kgl2001/BeebSCSIHostAdaptor/README.md

# BeebSCSIHostAdaptor
SCSI Host Adaptor that allows BBC &amp; Master Computers to interface with various SCSI Hard Disk Drives.

Please refer to the following discussion on Stardot for further details: https://stardot.org.uk/forums/viewtopic.php?f=3&t=18815

## Author

BeebSCSIHostAdaptor is developed and maintained by Ken Lowe.

The design is based on the BeebSCSI project by Simon Inns: https://github.com/simoninns/BeebSCSI

## Software License (GPLv3)

    BeebSCSI is free software: you can redistribute it and/or modify
    it under the terms of the GNU General Public License as published by
    the Free Software Foundation, either version 3 of the License, or
    (at your option) any later version.

    BeebSCSI is distributed in the hope that it will be useful,
    but WITHOUT ANY WARRANTY; without even the implied warranty of
    MERCHANTABILITY or FITNESS FOR A PARTICULAR PURPOSE.  See the
    GNU General Public License for more details.

    You should have received a copy of the GNU General Public License
    along with BeebSCSI.  If not, see <http://www.gnu.org/licenses/>.
    
## Hardware License (Creative Commons BY-SA 4.0)

Please see the following link for details: https://creativecommons.org/licenses/by-sa/4.0/

You are free to:

Share - copy and redistribute the material in any medium or format
Adapt - remix, transform, and build upon the material
for any purpose, even commercially.

This license is acceptable for Free Cultural Works.

The licensor cannot revoke these freedoms as long as you follow the license terms.

Under the following terms:

Attribution - You must give appropriate credit, provide a link to the license, and indicate if changes were made. You may do so in any reasonable manner, but not in any way that suggests the licensor endorses you or your use.

ShareAlike - If you remix, transform, or build upon the material, you must distribute your contributions under the same license as the original.

No additional restrictions - You may not apply legal terms or technological measures that legally restrict others from doing anything the license permits.
