kgl2001/BeebSCSIHostAdaptor/SCSIConnector - 80 pin/SCSIConnector.kicad_pcb

## KiCad design SCSIConnector - 80 pin/SCSIConnector.kicad_pcb (2021-02-13)

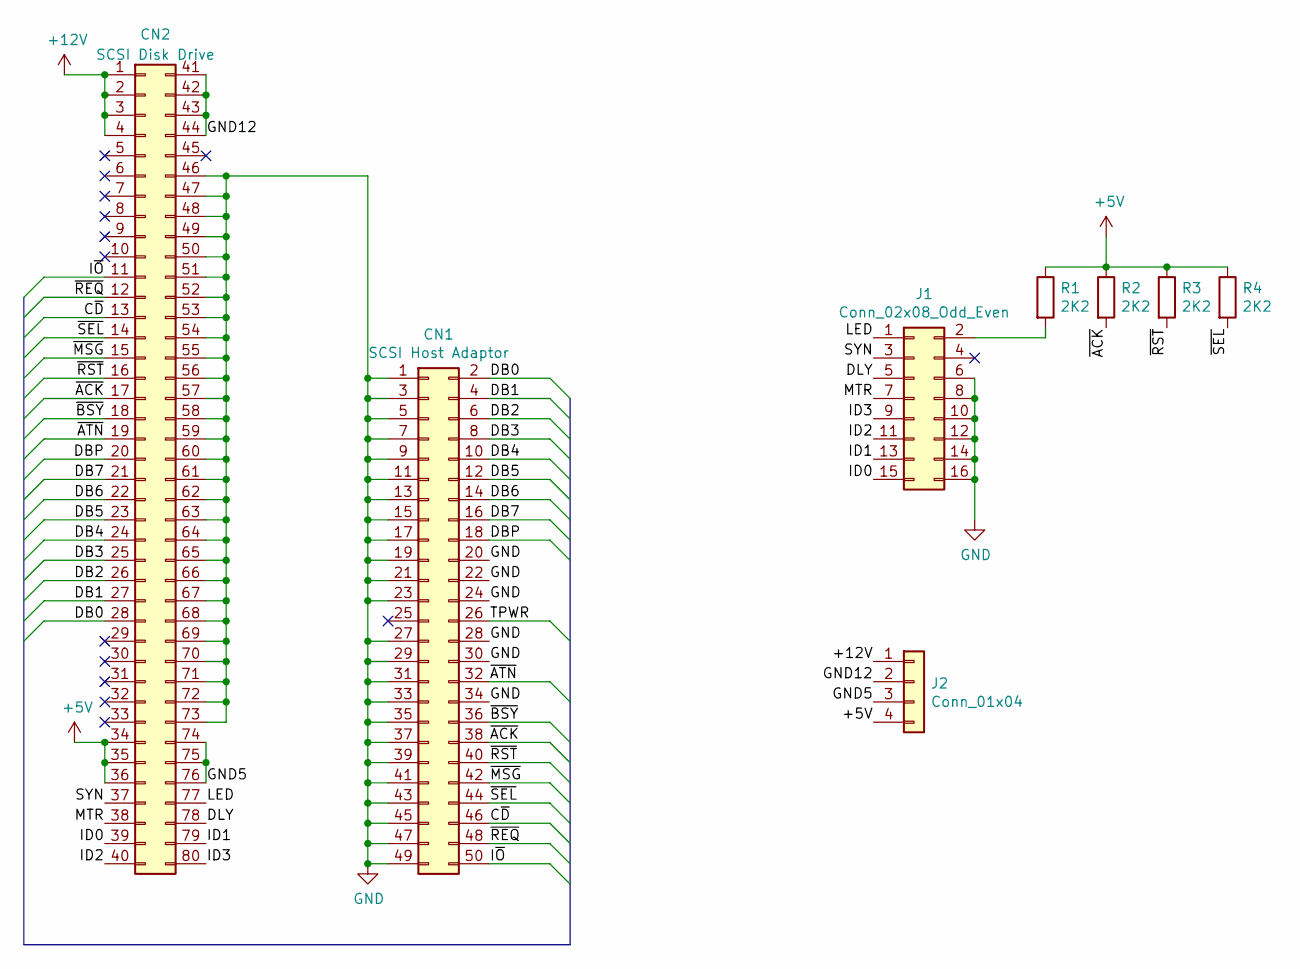
[picture p1: schematic SCSIConnector.sch]

Parts:
CN1: SCSI Host Adaptor; PinSocket_2x25_P2.54mm_Vertical
CN2: SCSI Disk Drive; TE_787311-4
J1: Conn_02x08_Odd_Even; PinHeader_2x08_P2.54mm_Vertical
J2: Conn_01x04; conn_hdd_15-24-4449
R1, R2, R3, R4: 2K2; R_Axial_DIN0204_L3.6mm_D1.6mm_P5.08mm_Horizontal

Connections:
+5V: CN2.34, CN2.35, CN2.36, J2.4, R1.1, R2.1, R3.1, R4.1
+12V: CN2.1, CN2.2, CN2.3, CN2.4, J2.1
/C~D: CN1.46, CN2.13
/DB0: CN1.2, CN2.28
/DB1: CN1.4, CN2.27
/DB2: CN1.6, CN2.26
/DB3: CN1.8, CN2.25
/DB4: CN1.10, CN2.24
/DB5: CN1.12, CN2.23
/DB6: CN1.14, CN2.22
/DB7: CN1.16, CN2.21
/DBP: CN1.18, CN2.20
/DLY: CN2.78, J1.5
/GND5: CN2.74, CN2.75, CN2.76, J2.3
/GND12: CN2.41, CN2.42, CN2.43, CN2.44, J2.2
/ID0: CN2.39, J1.15
/ID1: CN2.79, J1.13
/ID2: CN2.40, J1.11
/ID3: CN2.80, J1.9
/I~O: CN1.50, CN2.11
/LED: CN2.77, J1.1
/MTR: CN2.38, J1.7
/SYN: CN2.37, J1.3
/TPWR: CN1.26
/~ACK: CN1.38, CN2.17, R2.2
/~ATN: CN1.32, CN2.19
/~BSY: CN1.36, CN2.18
/~MSG: CN1.42, CN2.15
/~REQ: CN1.48, CN2.12
/~RST: CN1.40, CN2.16, R3.2
/~SEL: CN1.44, CN2.14, R4.2
GND: CN1.1, CN1.3, CN1.5, CN1.7, CN1.9, CN1.11, CN1.13, CN1.15, CN1.17, CN1.19, CN1.20, CN1.21, CN1.22, CN1.23, CN1.24, CN1.27, CN1.28, CN1.29, CN1.30, CN1.31, CN1.33, CN1.34, CN1.35, CN1.37, CN1.39, CN1.41, CN1.43, CN1.45, CN1.47, CN1.49, CN2.46, CN2.47, CN2.48, CN2.49, CN2.50, CN2.51, CN2.52, CN2.53, CN2.54, CN2.55, CN2.56, CN2.57, CN2.58, CN2.59, CN2.60, CN2.61, CN2.62, CN2.63, CN2.64, CN2.65, CN2.66, CN2.67, CN2.68, CN2.69, CN2.70, CN2.71, CN2.72, CN2.73, J1.6, J1.8, J1.10, J1.12, J1.14, J1.16
unnamed: J1.2, R1.2

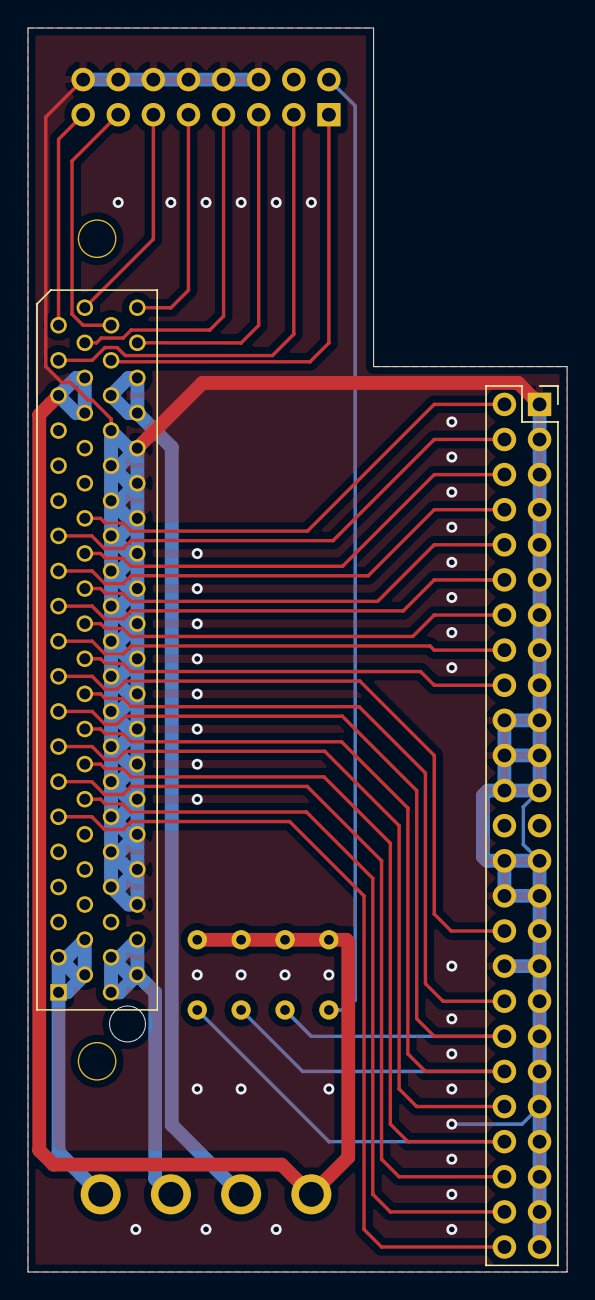
[picture p2: board SCSIConnector.kicad_pcb from above]

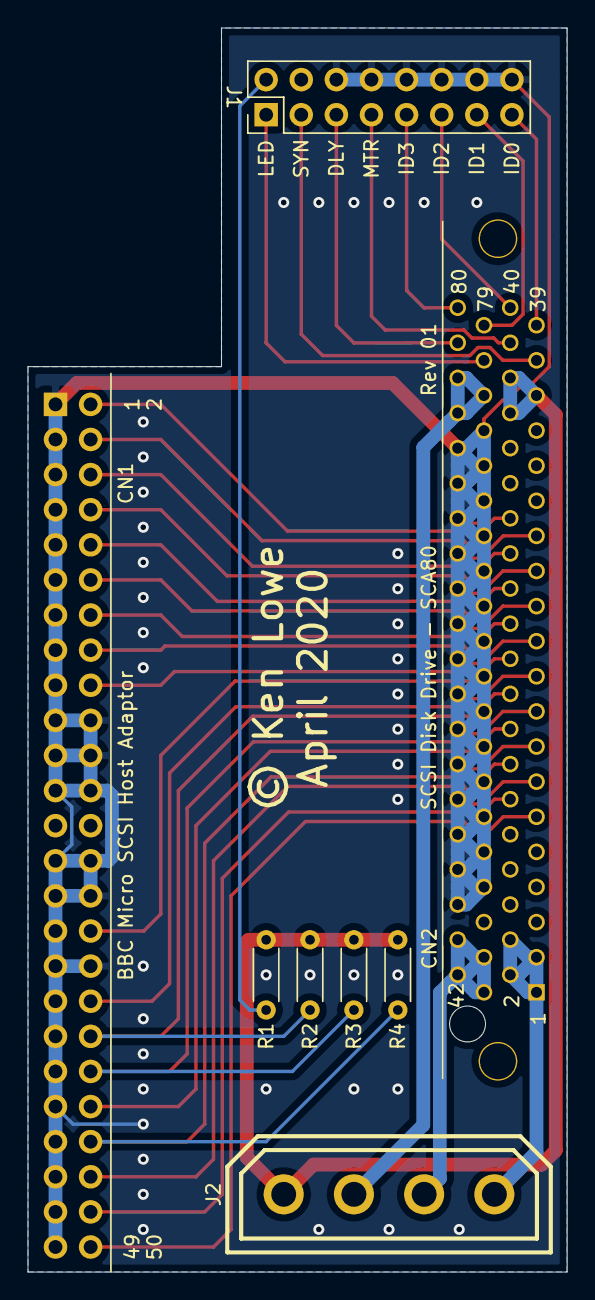
[picture p3: board SCSIConnector.kicad_pcb from below]

Board: 2 copper layers, 39.0 x 90.0 mm, 8 parts (6 on the bottom side), 32 nets.
