kgl2001/BeebSCSIHostAdaptor/SCSIConnector - 80 pin Buffered/SCSIConnectorA.kicad_pcb

## KiCad design SCSIConnector - 80 pin Buffered/SCSIConnectorA.kicad_pcb (2021-02-13)

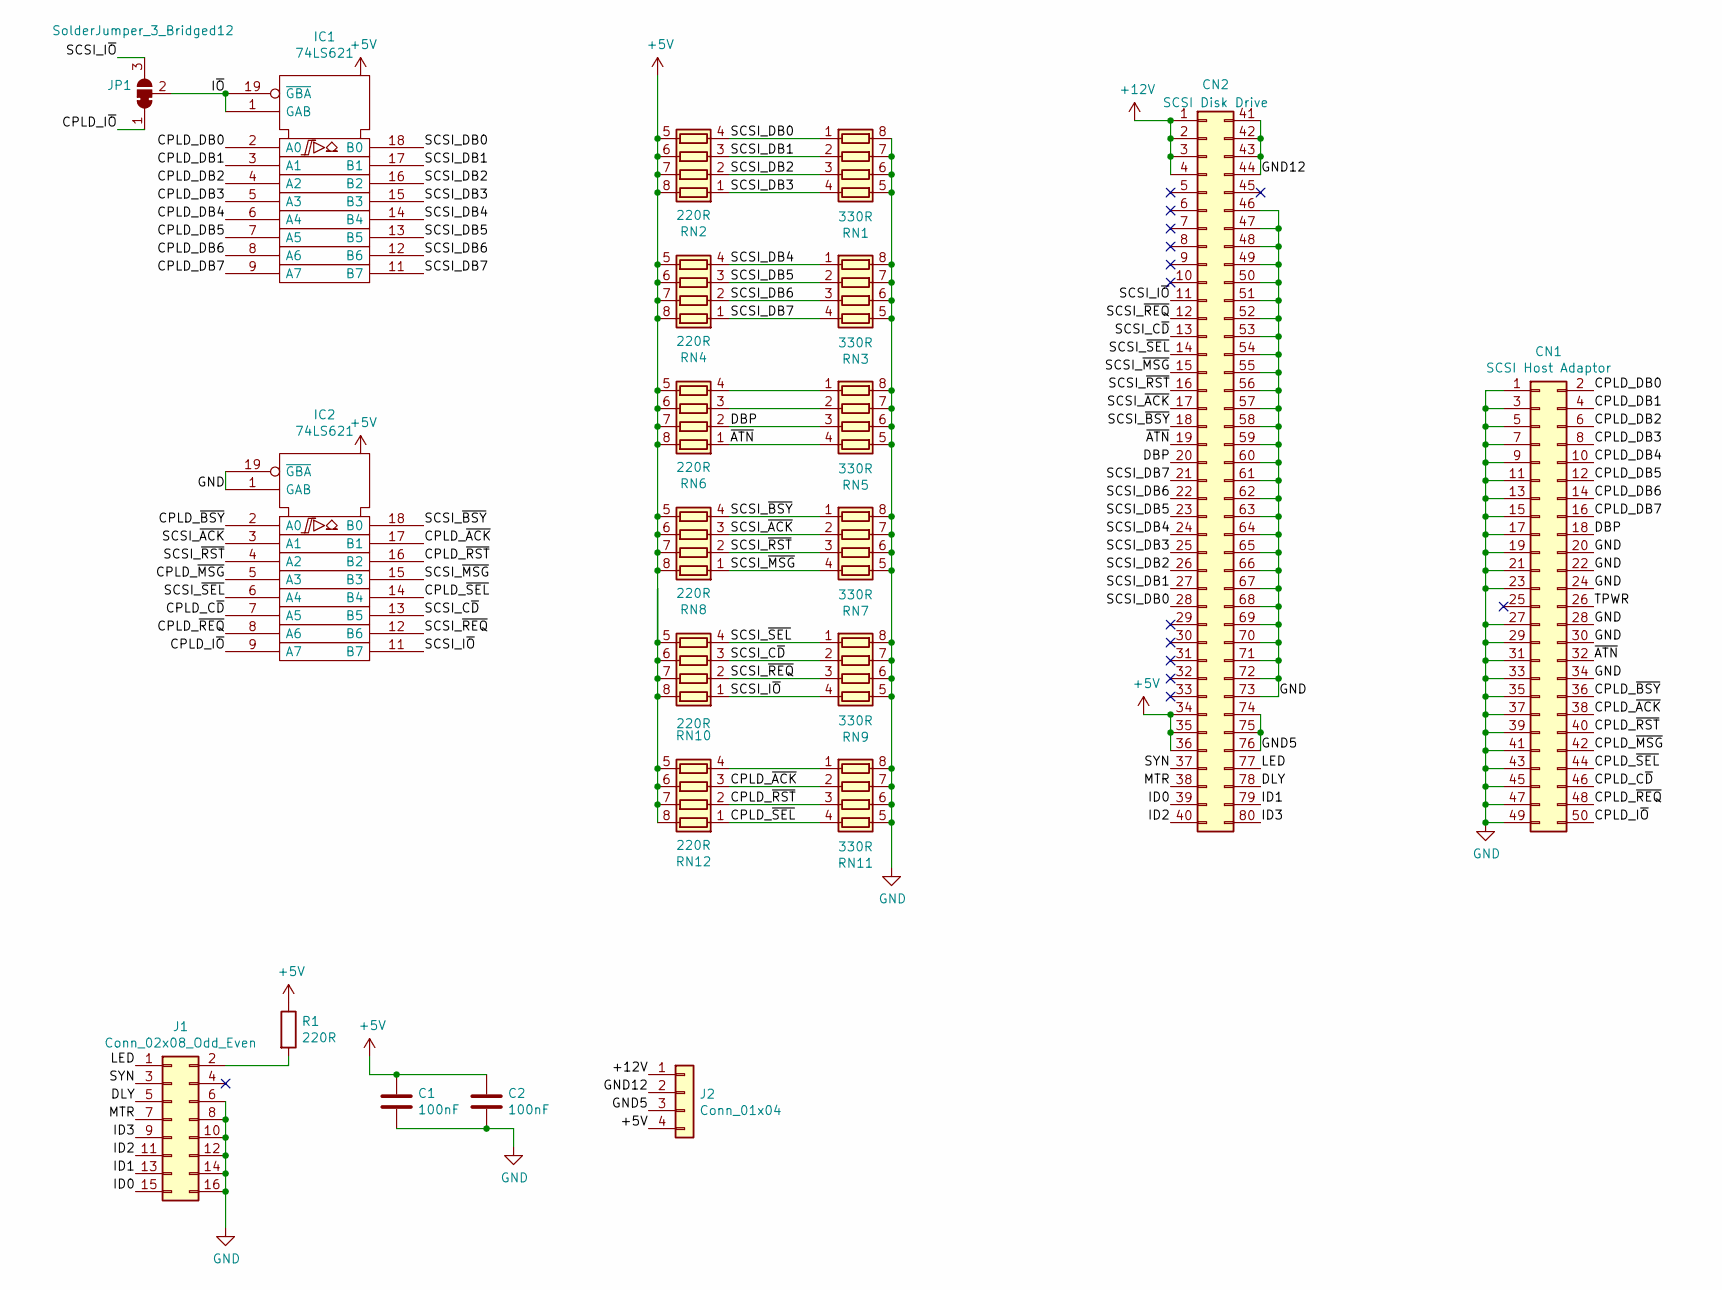
[picture p4: schematic SCSIConnectorA.sch]

Parts:
C1, C2: 100nF; C_0603_1608Metric
CN1: SCSI Host Adaptor; PinSocket_2x25_P2.54mm_Vertical
CN2: SCSI Disk Drive; TE_787311-4
IC1, IC2: 74LS621; SOIC-20W_7.5x12.8mm_P1.27mm
J1: Conn_02x08_Odd_Even; PinHeader_2x08_P2.54mm_Vertical
J2: Conn_01x04; conn_hdd_15-24-4449
JP1: SolderJumper_3_Bridged12; SolderJumper-3_P1.3mm_Bridged12_RoundedPad1.0x1.5mm
R1: 220R; R_0603_1608Metric
RN1, RN3, RN5, RN7, RN9, RN11: 330R; R_Array_Concave_4x0402
RN2, RN4, RN6, RN8, RN10, RN12: 220R; R_Array_Concave_4x0402

Connections:
+5V: C1.1, C2.1, CN2.34, CN2.35, CN2.36, IC1.20 (VCC), IC2.20 (VCC), J2.4, R1.1, RN2.5 (R4.2), RN2.6 (R3.2), RN2.7 (R2.2), RN2.8 (R1.2), RN4.5 (R4.2), RN4.6 (R3.2), RN4.7 (R2.2), RN4.8 (R1.2), RN6.5 (R4.2), RN6.6 (R3.2), RN6.7 (R2.2), RN6.8 (R1.2), RN8.5 (R4.2), RN8.6 (R3.2), RN8.7 (R2.2), RN8.8 (R1.2), RN10.5 (R4.2), RN10.6 (R3.2), RN10.7 (R2.2), RN10.8 (R1.2), RN12.5 (R4.2), RN12.6 (R3.2), RN12.7 (R2.2), RN12.8 (R1.2)
+12V: CN2.1, CN2.2, CN2.3, CN2.4, J2.1
/CPLD_C~D: CN1.46, IC2.7 (A5)
/CPLD_DB0: CN1.2, IC1.2 (A0)
/CPLD_DB1: CN1.4, IC1.3 (A1)
/CPLD_DB2: CN1.6, IC1.4 (A2)
/CPLD_DB3: CN1.8, IC1.5 (A3)
/CPLD_DB4: CN1.10, IC1.6 (A4)
/CPLD_DB5: CN1.12, IC1.7 (A5)
/CPLD_DB6: CN1.14, IC1.8 (A6)
/CPLD_DB7: CN1.16, IC1.9 (A7)
/CPLD_I~O: CN1.50, IC2.9 (A7), JP1.1 (A)
/CPLD_~ACK: CN1.38, IC2.17 (B1), RN11.2 (R2.1), RN12.3 (R3.1)
/CPLD_~BSY: CN1.36, IC2.2 (A0)
/CPLD_~MSG: CN1.42, IC2.5 (A3)
/CPLD_~REQ: CN1.48, IC2.8 (A6)
/CPLD_~RST: CN1.40, IC2.16 (B2), RN11.3 (R3.1), RN12.2 (R2.1)
/CPLD_~SEL: CN1.44, IC2.14 (B4), RN11.4 (R4.1), RN12.1 (R1.1)
/DBP: CN1.18, CN2.20, RN5.3 (R3.1), RN6.2 (R2.1)
/DLY: CN2.78, J1.5
/GND5: CN2.74, CN2.75, CN2.76, J2.3
/GND12: CN2.41, CN2.42, CN2.43, CN2.44, J2.2
/ID0: CN2.39, J1.15
/ID1: CN2.79, J1.13
/ID2: CN2.40, J1.11
/ID3: CN2.80, J1.9
/I~O: IC1.1 (GAB), IC1.19 (~GBA), JP1.2 (C)
/LED: CN2.77, J1.1
/MTR: CN2.38, J1.7
/SCSI_C~D: CN2.13, IC2.13 (B5), RN9.2 (R2.1), RN10.3 (R3.1)
/SCSI_DB0: CN2.28, IC1.18 (B0), RN1.1 (R1.1), RN2.4 (R4.1)
/SCSI_DB1: CN2.27, IC1.17 (B1), RN1.2 (R2.1), RN2.3 (R3.1)
/SCSI_DB2: CN2.26, IC1.16 (B2), RN1.3 (R3.1), RN2.2 (R2.1)
/SCSI_DB3: CN2.25, IC1.15 (B3), RN1.4 (R4.1), RN2.1 (R1.1)
/SCSI_DB4: CN2.24, IC1.14 (B4), RN3.1 (R1.1), RN4.4 (R4.1)
/SCSI_DB5: CN2.23, IC1.13 (B5), RN3.2 (R2.1), RN4.3 (R3.1)
/SCSI_DB6: CN2.22, IC1.12 (B6), RN3.3 (R3.1), RN4.2 (R2.1)
/SCSI_DB7: CN2.21, IC1.11 (B7), RN3.4 (R4.1), RN4.1 (R1.1)
/SCSI_I~O: CN2.11, IC2.11 (B7), JP1.3 (B), RN9.4 (R4.1), RN10.1 (R1.1)
/SCSI_~ACK: CN2.17, IC2.3 (A1), RN7.2 (R2.1), RN8.3 (R3.1)
/SCSI_~BSY: CN2.18, IC2.18 (B0), RN7.1 (R1.1), RN8.4 (R4.1)
/SCSI_~MSG: CN2.15, IC2.15 (B3), RN7.4 (R4.1), RN8.1 (R1.1)
/SCSI_~REQ: CN2.12, IC2.12 (B6), RN9.3 (R3.1), RN10.2 (R2.1)
/SCSI_~RST: CN2.16, IC2.4 (A2), RN7.3 (R3.1), RN8.2 (R2.1)
/SCSI_~SEL: CN2.14, IC2.6 (A4), RN9.1 (R1.1), RN10.4 (R4.1)
/SYN: CN2.37, J1.3
/TPWR: CN1.26
/~ATN: CN1.32, CN2.19, RN5.4 (R4.1), RN6.1 (R1.1)
GND: C1.2, C2.2, CN1.1, CN1.3, CN1.5, CN1.7, CN1.9, CN1.11, CN1.13, CN1.15, CN1.17, CN1.19, CN1.20, CN1.21, CN1.22, CN1.23, CN1.24, CN1.27, CN1.28, CN1.29, CN1.30, CN1.31, CN1.33, CN1.34, CN1.35, CN1.37, CN1.39, CN1.41, CN1.43, CN1.45, CN1.47, CN1.49, CN2.46, CN2.47, CN2.48, CN2.49, CN2.50, CN2.51, CN2.52, CN2.53, CN2.54, CN2.55, CN2.56, CN2.57, CN2.58, CN2.59, CN2.60, CN2.61, CN2.62, CN2.63, CN2.64, CN2.65, CN2.66, CN2.67, CN2.68, CN2.69, CN2.70, CN2.71, CN2.72, CN2.73, IC1.10 (GND), IC2.1 (GAB), IC2.10 (GND), IC2.19 (~GBA), J1.6, J1.8, J1.10, J1.12, J1.14, J1.16, RN1.5 (R4.2), RN1.6 (R3.2), RN1.7 (R2.2), RN1.8 (R1.2), RN3.5 (R4.2), RN3.6 (R3.2), RN3.7 (R2.2), RN3.8 (R1.2), RN5.5 (R4.2), RN5.6 (R3.2), RN5.7 (R2.2), RN5.8 (R1.2), RN7.5 (R4.2), RN7.6 (R3.2), RN7.7 (R2.2), RN7.8 (R1.2), RN9.5 (R4.2), RN9.6 (R3.2), RN9.7 (R2.2), RN9.8 (R1.2), RN11.5 (R4.2), RN11.6 (R3.2), RN11.7 (R2.2), RN11.8 (R1.2)
unnamed: J1.2, R1.2
unnamed: RN5.1 (R1.1), RN6.4 (R4.1)
unnamed: RN5.2 (R2.1), RN6.3 (R3.1)
unnamed: RN11.1 (R1.1), RN12.4 (R4.1)

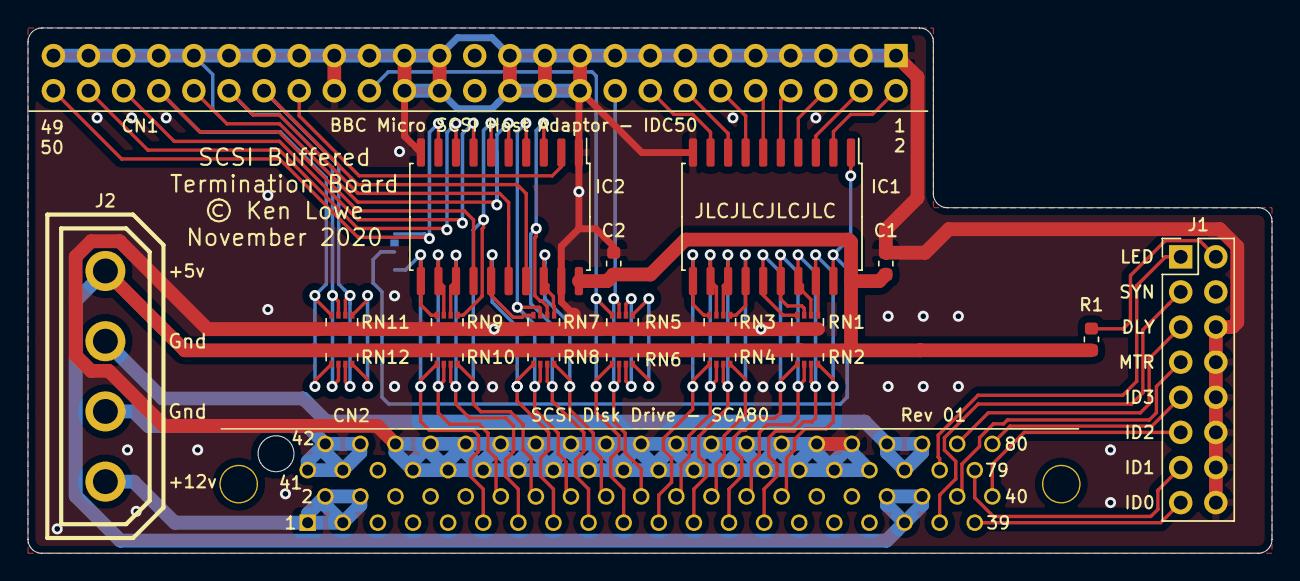
[picture p5: board SCSIConnectorA.kicad_pcb from above]

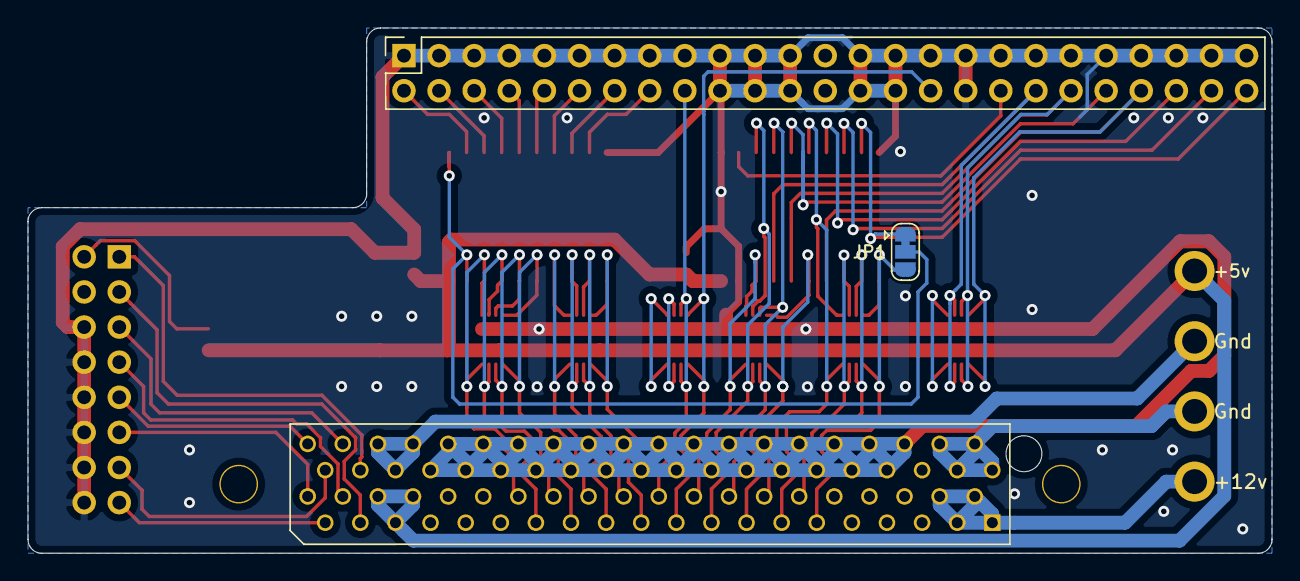
[picture p6: board SCSIConnectorA.kicad_pcb from below]

Board: 2 copper layers, 90.0 x 38.0 mm, 22 parts (3 on the bottom side), 52 nets.
