kgl2001/BeebSCSIHostAdaptor/SCSIAdaptorXC9572-64 - Rev 02/SCSIAdaptor.kicad_pcb

## KiCad design SCSIAdaptorXC9572-64 - Rev 02/SCSIAdaptor.kicad_pcb (2021-02-13)

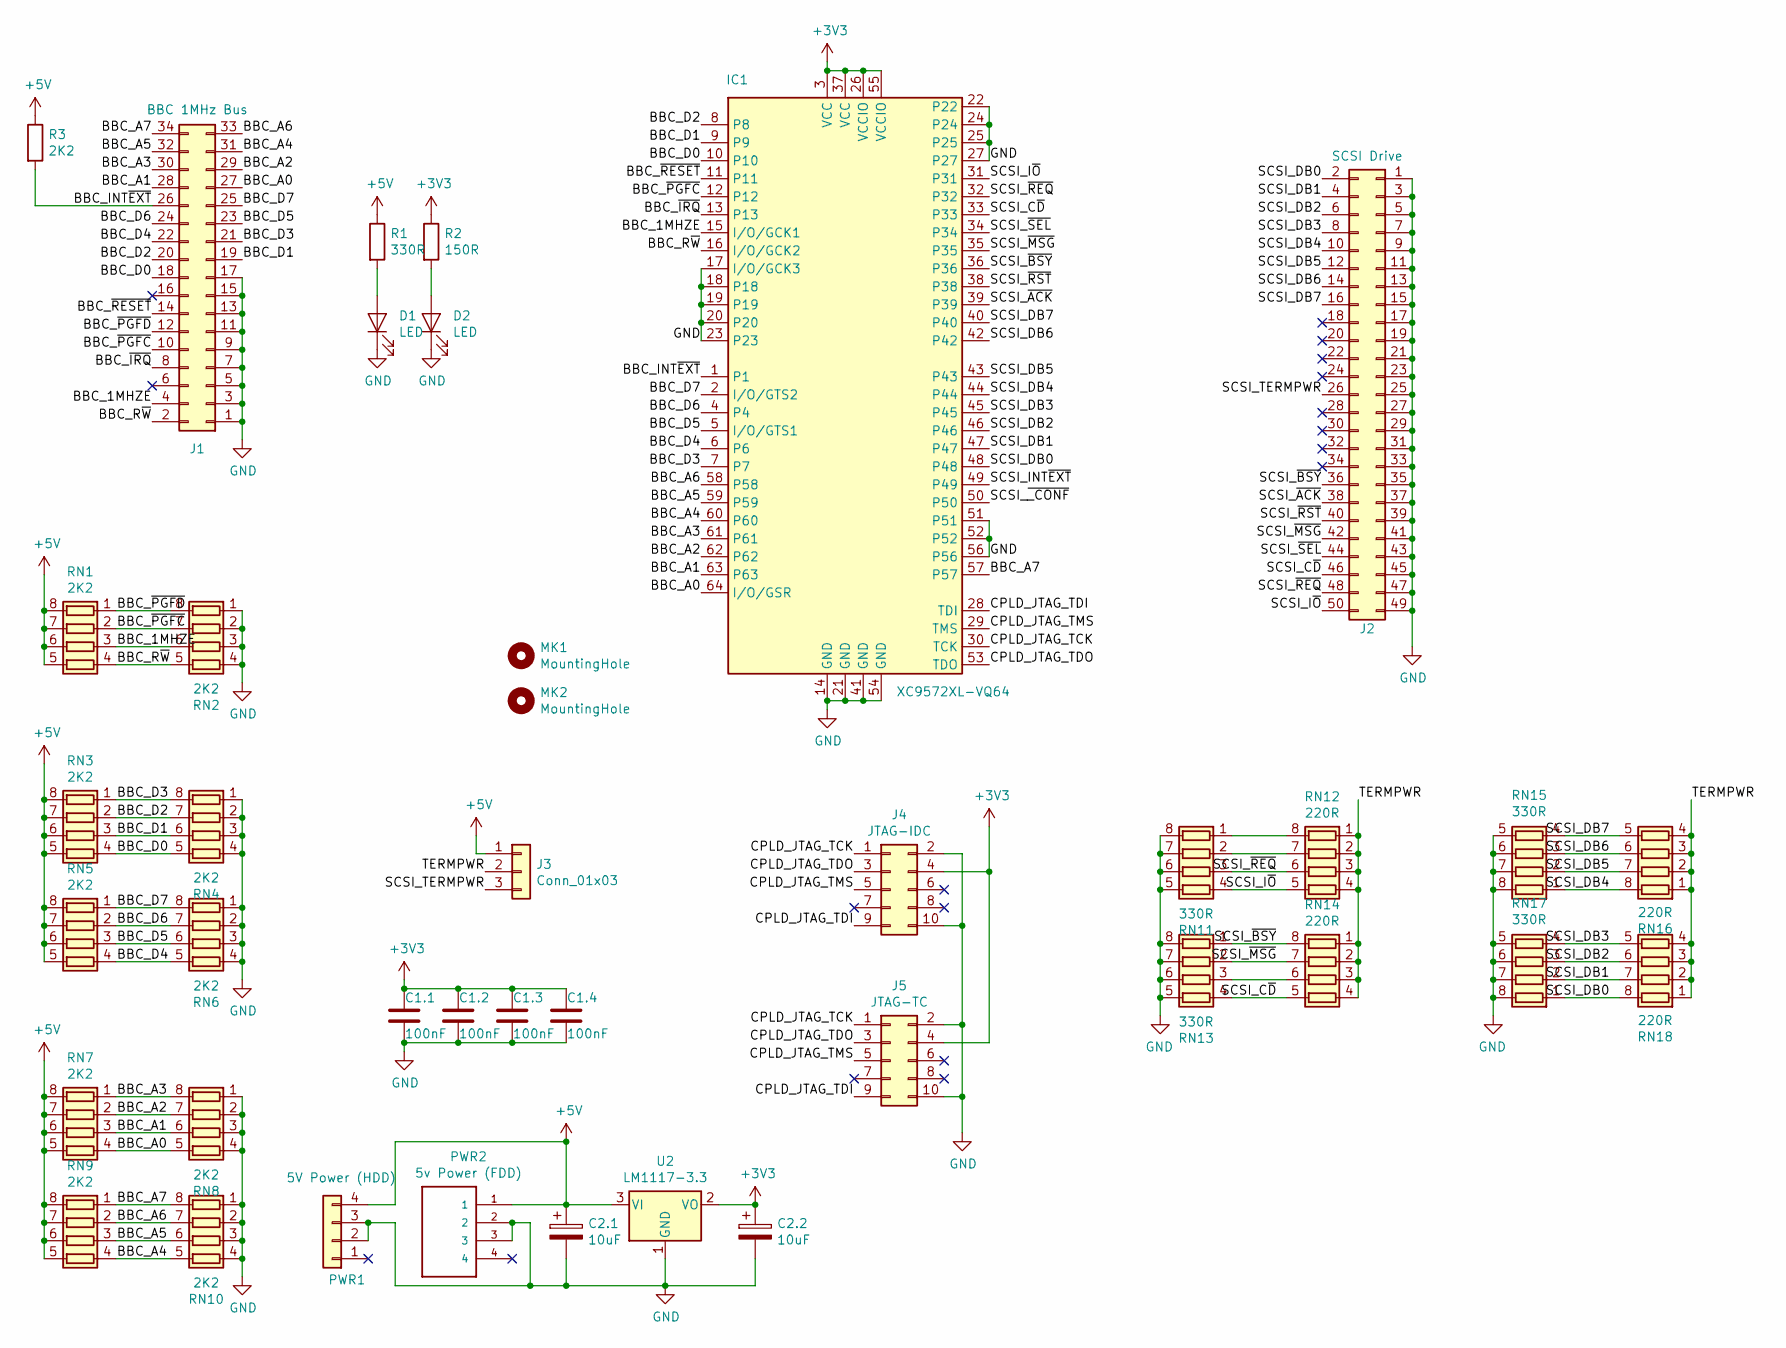
[picture p7: schematic SCSIAdaptor.sch]

Parts:
C1.1, C1.2, C1.3, C1.4: 100nF; C_0805_2012Metric
C2.1, C2.2: 10uF; C_1206_3216Metric
D1, D2: LED; LED_0603_1608Metric
IC1: XC9572XL-VQ64; TQFP-64_10x10mm_P0.5mm
J1: BBC 1MHz Bus; IDC-Header_2x17_P2.54mm_Horizontal
J2: SCSI Drive; IDC-Header_2x25_P2.54mm_Horizontal
J3: Conn_01x03; SolderJumper-3_P1.3mm_Bridged12_RoundedPad1.0x1.5mm
J4: JTAG-IDC; PinHeader_2x05_P2.54mm_Vertical
J5: JTAG-TC; Tag-Connect_TC2050-IDC-NL_2x05_P1.27mm_Vertical
MK1, MK2: MountingHole; MountingHole_3.2mm_M3
PWR1: 5V Power (HDD); conn_hdd_15-24-4441
PWR2: 5v Power (FDD); TE_171826-4
R1: 330R; R_0402_1005Metric
R2: 150R; R_0402_1005Metric
R3: 2K2; R_0402_1005Metric
RN1, RN2, RN3, RN4, RN5, RN6, RN7, RN8, RN9, RN10: 2K2; R_Array_Concave_4x0402
RN11, RN13, RN15, RN17: 330R; R_Array_Concave_4x0402
RN12, RN14, RN16, RN18: 220R; R_Array_Concave_4x0402
U2: LM1117-3.3; SOT-223-3_TabPin2

Connections:
+3V3: C1.1.1, C1.2.1, C1.3.1, C1.4.1, C2.2.1, IC1.3 (VCC), IC1.26 (VCCIO), IC1.37 (VCC), IC1.55 (VCCIO), J4.4, J5.4, R2.1, U2.2 (VO)
+5V: C2.1.1, J3.1, PWR1.4, PWR2.1, R1.1, R3.1, RN1.5 (R4.2), RN1.6 (R3.2), RN1.7 (R2.2), RN1.8 (R1.2), RN3.5 (R4.2), RN3.6 (R3.2), RN3.7 (R2.2), RN3.8 (R1.2), RN5.5 (R4.2), RN5.6 (R3.2), RN5.7 (R2.2), RN5.8 (R1.2), RN7.5 (R4.2), RN7.6 (R3.2), RN7.7 (R2.2), RN7.8 (R1.2), RN9.5 (R4.2), RN9.6 (R3.2), RN9.7 (R2.2), RN9.8 (R1.2), U2.3 (VI)
/BBC_1MHZE: IC1.15 (I/O/GCK1), J1.4, RN1.3 (R3.1), RN2.6 (R3.2)
/BBC_A0: IC1.64 (I/O/GSR), J1.27, RN7.4 (R4.1), RN8.5 (R4.2)
/BBC_A1: IC1.63, J1.28, RN7.3 (R3.1), RN8.6 (R3.2)
/BBC_A2: IC1.62, J1.29, RN7.2 (R2.1), RN8.7 (R2.2)
/BBC_A3: IC1.61, J1.30, RN7.1 (R1.1), RN8.8 (R1.2)
/BBC_A4: IC1.60, J1.31, RN9.4 (R4.1), RN10.5 (R4.2)
/BBC_A5: IC1.59, J1.32, RN9.3 (R3.1), RN10.6 (R3.2)
/BBC_A6: IC1.58, J1.33, RN9.2 (R2.1), RN10.7 (R2.2)
/BBC_A7: IC1.57, J1.34, RN9.1 (R1.1), RN10.8 (R1.2)
/BBC_D0: IC1.10, J1.18, RN3.4 (R4.1), RN4.5 (R4.2)
/BBC_D1: IC1.9, J1.19, RN3.3 (R3.1), RN4.6 (R3.2)
/BBC_D2: IC1.8, J1.20, RN3.2 (R2.1), RN4.7 (R2.2)
/BBC_D3: IC1.7, J1.21, RN3.1 (R1.1), RN4.8 (R1.2)
/BBC_D4: IC1.6, J1.22, RN5.4 (R4.1), RN6.5 (R4.2)
/BBC_D5: IC1.5 (I/O/GTS1), J1.23, RN5.3 (R3.1), RN6.6 (R3.2)
/BBC_D6: IC1.4, J1.24, RN5.2 (R2.1), RN6.7 (R2.2)
/BBC_D7: IC1.2 (I/O/GTS2), J1.25, RN5.1 (R1.1), RN6.8 (R1.2)
/BBC_INT~EXT: IC1.1, J1.26, R3.2
/BBC_R~W: IC1.16 (I/O/GCK2), J1.2, RN1.4 (R4.1), RN2.5 (R4.2)
/BBC_~IRQ: IC1.13, J1.8
/BBC_~PGFC: IC1.12, J1.10, RN1.2 (R2.1), RN2.7 (R2.2)
/BBC_~PGFD: J1.12, RN1.1 (R1.1), RN2.8 (R1.2)
/BBC_~RESET: IC1.11, J1.14
/CPLD_JTAG_TCK: IC1.30 (TCK), J4.1, J5.1
/CPLD_JTAG_TDI: IC1.28 (TDI), J4.9, J5.9
/CPLD_JTAG_TDO: IC1.53 (TDO), J4.3, J5.3
/CPLD_JTAG_TMS: IC1.29 (TMS), J4.5, J5.5
/SCSI_C~D: IC1.33, J2.46, RN13.4 (R4.1), RN14.5 (R4.2)
/SCSI_DB0: IC1.48, J2.2, RN17.1 (R1.1), RN18.8 (R1.2)
/SCSI_DB1: IC1.47, J2.4, RN17.2 (R2.1), RN18.7 (R2.2)
/SCSI_DB2: IC1.46, J2.6, RN17.3 (R3.1), RN18.6 (R3.2)
/SCSI_DB3: IC1.45, J2.8, RN17.4 (R4.1), RN18.5 (R4.2)
/SCSI_DB4: IC1.44, J2.10, RN15.1 (R1.1), RN16.8 (R1.2)
/SCSI_DB5: IC1.43, J2.12, RN15.2 (R2.1), RN16.7 (R2.2)
/SCSI_DB6: IC1.42, J2.14, RN15.3 (R3.1), RN16.6 (R3.2)
/SCSI_DB7: IC1.40, J2.16, RN15.4 (R4.1), RN16.5 (R4.2)
/SCSI_INT~EXT: IC1.49
/SCSI_I~O: IC1.31, J2.50, RN11.4 (R4.1), RN12.5 (R4.2)
/SCSI_TERMPWR: J2.26, J3.3
/SCSI_~ACK: IC1.39, J2.38
/SCSI_~BSY: IC1.36, J2.36, RN13.1 (R1.1), RN14.8 (R1.2)
/SCSI_~MSG: IC1.35, J2.42, RN13.2 (R2.1), RN14.7 (R2.2)
/SCSI_~REQ: IC1.32, J2.48, RN11.3 (R3.1), RN12.6 (R3.2)
/SCSI_~RST: IC1.38, J2.40
/SCSI_~SEL: IC1.34, J2.44
/SCSI_~_CONF: IC1.50
/TERMPWR: J3.2, RN12.1 (R1.1), RN12.2 (R2.1), RN12.3 (R3.1), RN12.4 (R4.1), RN14.1 (R1.1), RN14.2 (R2.1), RN14.3 (R3.1), RN14.4 (R4.1), RN16.1 (R1.1), RN16.2 (R2.1), RN16.3 (R3.1), RN16.4 (R4.1), RN18.1 (R1.1), RN18.2 (R2.1), RN18.3 (R3.1), RN18.4 (R4.1)
GND: C1.1.2, C1.2.2, C1.3.2, C1.4.2, C2.1.2, C2.2.2, D1.1 (K), D2.1 (K), IC1.14 (GND), IC1.17 (I/O/GCK3), IC1.18, IC1.19, IC1.20, IC1.21 (GND), IC1.22, IC1.23, IC1.24, IC1.25, IC1.27, IC1.41 (GND), IC1.51, IC1.52, IC1.54 (GND), IC1.56, J1.1, J1.3, J1.5, J1.7, J1.9, J1.11, J1.13, J1.15, J1.17, J2.1, J2.3, J2.5, J2.7, J2.9, J2.11, J2.13, J2.15, J2.17, J2.19, J2.21, J2.23, J2.25, J2.27, J2.29, J2.31, J2.33, J2.35, J2.37, J2.39, J2.41, J2.43, J2.45, J2.47, J2.49, J4.2, J4.10, J5.2, J5.10, PWR1.2, PWR1.3, PWR2.2, PWR2.3, RN2.1 (R1.1), RN2.2 (R2.1), RN2.3 (R3.1), RN2.4 (R4.1), RN4.1 (R1.1), RN4.2 (R2.1), RN4.3 (R3.1), RN4.4 (R4.1), RN6.1 (R1.1), RN6.2 (R2.1), RN6.3 (R3.1), RN6.4 (R4.1), RN8.1 (R1.1), RN8.2 (R2.1), RN8.3 (R3.1), RN8.4 (R4.1), RN10.1 (R1.1), RN10.2 (R2.1), RN10.3 (R3.1), RN10.4 (R4.1), RN11.5 (R4.2), RN11.6 (R3.2), RN11.7 (R2.2), RN11.8 (R1.2), RN13.5 (R4.2), RN13.6 (R3.2), RN13.7 (R2.2), RN13.8 (R1.2), RN15.5 (R4.2), RN15.6 (R3.2), RN15.7 (R2.2), RN15.8 (R1.2), RN17.5 (R4.2), RN17.6 (R3.2), RN17.7 (R2.2), RN17.8 (R1.2), U2.1 (GND)
unnamed: D1.2 (A), R1.2
unnamed: D2.2 (A), R2.2
unnamed: RN11.1 (R1.1), RN12.8 (R1.2)
unnamed: RN11.2 (R2.1), RN12.7 (R2.2)
unnamed: RN13.3 (R3.1), RN14.6 (R3.2)

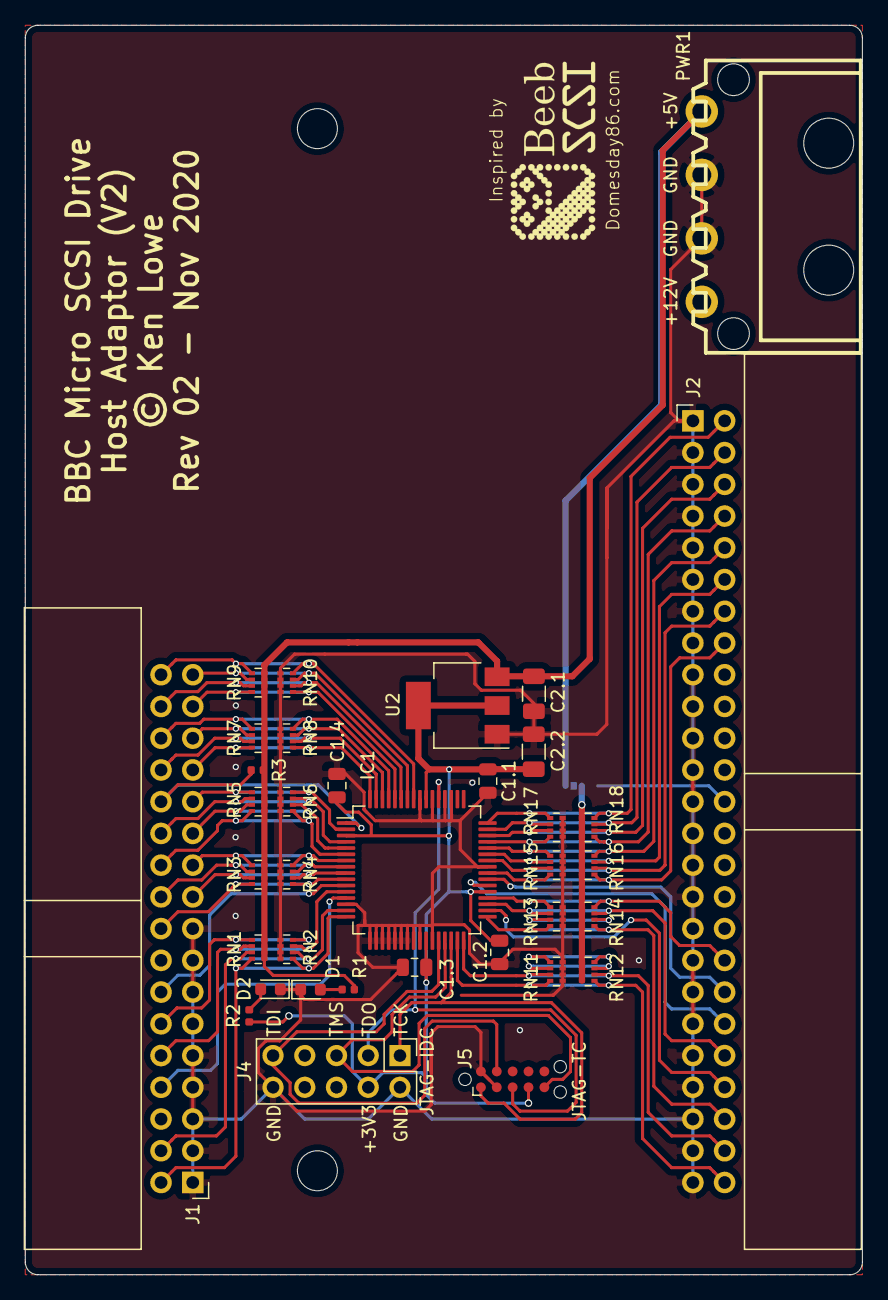
[picture p8: board SCSIAdaptor.kicad_pcb from above]

Board: 2 copper layers, 67.0 x 100.0 mm, 39 parts (1 on the bottom side), 53 nets.
