kgl2001/BeebSCSIHostAdaptor/SCSIAdaptorXC9572-64 - Rev 02/SCSIAdaptor_AMPPower.kicad_pcb

## KiCad design SCSIAdaptorXC9572-64 - Rev 02/SCSIAdaptor_AMPPower.kicad_pcb (2021-02-13)

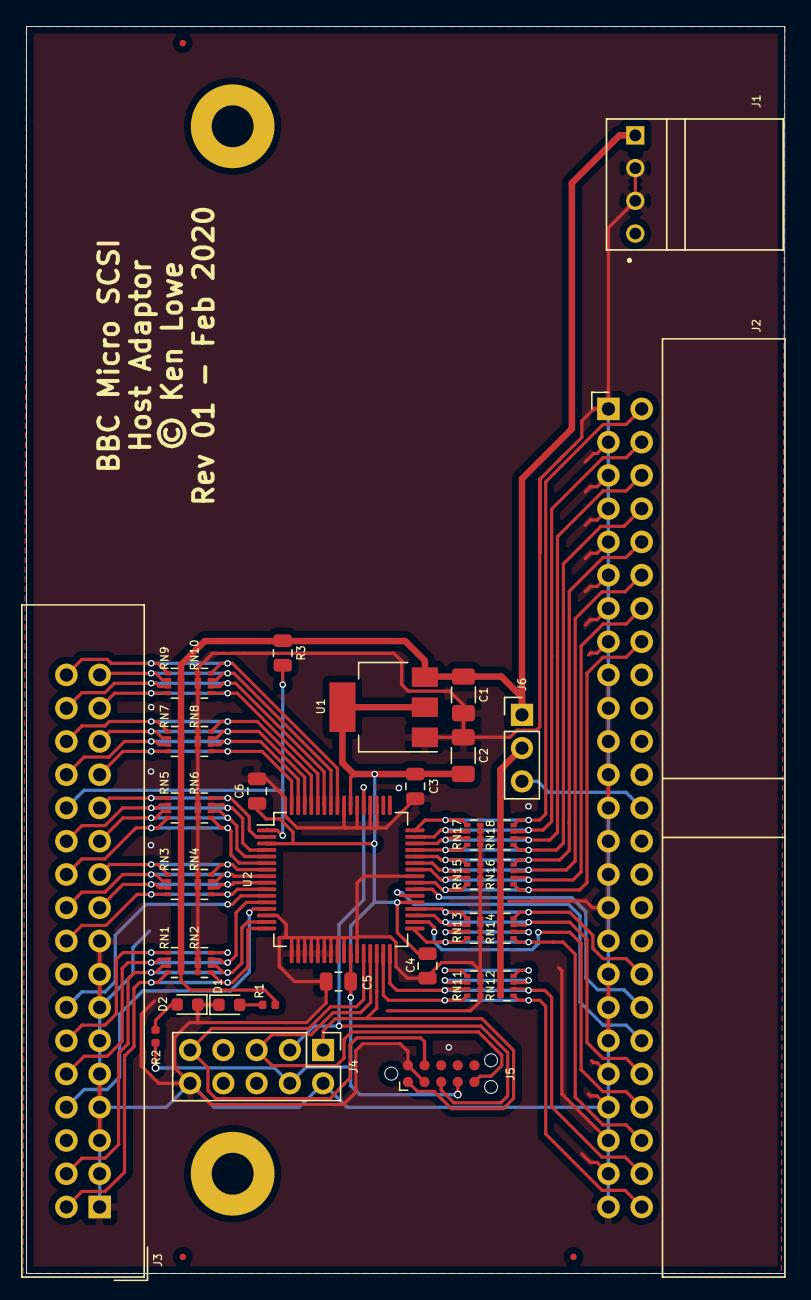
[picture p9: board SCSIAdaptor_AMPPower.kicad_pcb from above]

Board: 2 copper layers, 57.9 x 95.2 mm, 42 parts (0 on the bottom side), 53 nets.

Parts:
C1, C2: 10uF; C_1206_3216Metric
C3, C4, C5, C6: 100nF; C_0805_2012Metric
D1, D2: LED; LED_0603_1608Metric
F1, F2, F3: Fiducial; Fiducial_0.5mm_Dia_1mm_Outer
J1: 5v Power (FDD); TE_171826-4
J2: SCSI Drive; IDC-Header_2x25_P2.54mm_Horizontal
J3: BBC 1MHz Bus; IDC-Header_2x17_P2.54mm_Vertical
J4: JTAG-IDC; PinHeader_2x05_P2.54mm_Vertical
J5: JTAG-TC; Tag-Connect_TC2050-IDC-NL_2x05_P1.27mm_Vertical
J6: Conn_01x03; PinHeader_1x03_P2.54mm_Vertical
MK1, MK2: MountingHole; MountingHole_3.2mm_M3_Pad
R1: 330R; R_0402_1005Metric
R2: 150R; R_0402_1005Metric
R3: 2K2; R_0805_2012Metric
RN1, RN2, RN3, RN4, RN5, RN6, RN7, RN8, RN9, RN10: 2K2; R_Array_Concave_4x0402
RN11, RN13, RN15, RN17: 330R; R_Array_Concave_4x0402
RN12, RN14, RN16, RN18: 220R; R_Array_Concave_4x0402
U1: LM1117-3.3; SOT-223-3_TabPin2
U2: XC9572XL-VQ64; TQFP-64_10x10mm_P0.5mm

Connections:
+3V3: C2.1, C3.1, C4.1, C5.1, C6.1, J4.4, J5.4, R2.1, U1.2, U2.3, U2.26, U2.37, U2.55
+5V: C1.1, J1.1, J6.1, R1.1, R3.1, RN1.5, RN1.6, RN1.7, RN1.8, RN3.5, RN3.6, RN3.7, RN3.8, RN5.5, RN5.6, RN5.7, RN5.8, RN7.5, RN7.6, RN7.7, RN7.8, RN9.5, RN9.6, RN9.7, RN9.8, U1.3
/BBC_1MHZE: J3.4, RN1.3, RN2.6, U2.15
/BBC_A0: J3.27, RN7.4, RN8.5, U2.64
/BBC_A1: J3.28, RN7.3, RN8.6, U2.63
/BBC_A2: J3.29, RN7.2, RN8.7, U2.62
/BBC_A3: J3.30, RN7.1, RN8.8, U2.61
/BBC_A4: J3.31, RN9.4, RN10.5, U2.60
/BBC_A5: J3.32, RN9.3, RN10.6, U2.59
/BBC_A6: J3.33, RN9.2, RN10.7, U2.58
/BBC_A7: J3.34, RN9.1, RN10.8, U2.57
/BBC_D0: J3.18, RN3.4, RN4.5, U2.10
/BBC_D1: J3.19, RN3.3, RN4.6, U2.9
/BBC_D2: J3.20, RN3.2, RN4.7, U2.8
/BBC_D3: J3.21, RN3.1, RN4.8, U2.7
/BBC_D4: J3.22, RN5.4, RN6.5, U2.6
/BBC_D5: J3.23, RN5.3, RN6.6, U2.5
/BBC_D6: J3.24, RN5.2, RN6.7, U2.4
/BBC_D7: J3.25, RN5.1, RN6.8, U2.2
/BBC_INT~EXT: J3.26, R3.2, U2.1
/BBC_R~W: J3.2, RN1.4, RN2.5, U2.16
/BBC_~IRQ: J3.8, U2.13
/BBC_~PGFC: J3.10, RN1.2, RN2.7, U2.12
/BBC_~PGFD: J3.12, RN1.1, RN2.8
/BBC_~RESET: J3.14, U2.11
/CPLD_JTAG_TCK: J4.1, J5.1, U2.30
/CPLD_JTAG_TDI: J4.9, J5.9, U2.28
/CPLD_JTAG_TDO: J4.3, J5.3, U2.53
/CPLD_JTAG_TMS: J4.5, J5.5, U2.29
/SCSI_C~D: J2.46, RN13.4, RN14.5, U2.33
/SCSI_DB0: J2.2, RN17.1, RN18.8, U2.48
/SCSI_DB1: J2.4, RN17.2, RN18.7, U2.47
/SCSI_DB2: J2.6, RN17.3, RN18.6, U2.46
/SCSI_DB3: J2.8, RN17.4, RN18.5, U2.45
/SCSI_DB4: J2.10, RN15.1, RN16.8, U2.44
/SCSI_DB5: J2.12, RN15.2, RN16.7, U2.43
/SCSI_DB6: J2.14, RN15.3, RN16.6, U2.42
/SCSI_DB7: J2.16, RN15.4, RN16.5, U2.40
/SCSI_I~O: J2.50, RN11.4, RN12.5, U2.31
/SCSI_TERMPWR: J2.26, J6.3
/SCSI_~ACK: J2.38, U2.39
/SCSI_~BSY: J2.36, RN13.1, RN14.8, U2.36
/SCSI_~MSG: J2.42, RN13.2, RN14.7, U2.35
/SCSI_~REQ: J2.48, RN11.3, RN12.6, U2.32
/SCSI_~RST: J2.40, U2.38
/SCSI_~SEL: J2.44, U2.34
/TERMPWR: J6.2, RN12.1, RN12.2, RN12.3, RN12.4, RN14.1, RN14.2, RN14.3, RN14.4, RN16.1, RN16.2, RN16.3, RN16.4, RN18.1, RN18.2, RN18.3, RN18.4
GND: C1.2, C2.2, C3.2, C4.2, C5.2, C6.2, D1.1, D2.1, J1.2, J1.3, J2.1, J2.3, J2.5, J2.7, J2.9, J2.11, J2.13, J2.15, J2.17, J2.19, J2.21, J2.23, J2.25, J2.27, J2.29, J2.31, J2.33, J2.35, J2.37, J2.39, J2.41, J2.43, J2.45, J2.47, J2.49, J3.1, J3.3, J3.5, J3.7, J3.9, J3.11, J3.13, J3.15, J3.17, J4.2, J4.10, J5.2, J5.10, RN2.1, RN2.2, RN2.3, RN2.4, RN4.1, RN4.2, RN4.3, RN4.4, RN6.1, RN6.2, RN6.3, RN6.4, RN8.1, RN8.2, RN8.3, RN8.4, RN10.1, RN10.2, RN10.3, RN10.4, RN11.5, RN11.6, RN11.7, RN11.8, RN13.5, RN13.6, RN13.7, RN13.8, RN15.5, RN15.6, RN15.7, RN15.8, RN17.5, RN17.6, RN17.7, RN17.8, U1.1, U2.14, U2.17, U2.18, U2.19, U2.20, U2.21, U2.22, U2.23, U2.24, U2.25, U2.27, U2.41, U2.51, U2.52, U2.54, U2.56
unnamed: D1.2, R1.2
unnamed: D2.2, R2.2
unnamed: RN11.1, RN12.8
unnamed: RN11.2, RN12.7
unnamed: RN13.3, RN14.6
