kgl2001/BeebSCSIHostAdaptor/SCSIAdaptor_XC9572XL-64_CPLD/SCSIAdaptorAddressDecoder.v

`timescale 1ns / 1ps
/************************************************************************
	 SCSIAdaptorAddressDecoder.v

	 Host adapter address decoder for BeebSCSI
    BeebSCSI - BBC Micro SCSI Drive Emulator
    Copyright (C) 2016 Simon Inns

	 This file is part of BeebSCSI.

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
	 Email: simon.inns@gmail.com

************************************************************************/
module SCSIAdaptorAddressDecoder(
	input [7:0] bbc_ADDRESS,
	input cleanPGFC,
	input n1MHZE,
	input nRW,
	
	output nFC40RD,
	output nFC41RD,
	output nFC40WR,
	output nFC42WR,
	output nFC43WR,
	output nFC44WR
	);

	// The 74LS138 dual 4-bit decoder IC is not clocked, so here we have to
	// use combinational logic to emulate it.  The 74LS138 uses negative logic
	// on the outputs.
	assign nFC40RD = ((bbc_ADDRESS == 8'h40) & ~nRW & ~n1MHZE & cleanPGFC) ? 1'b0 : 1'b1;
	assign nFC41RD = ((bbc_ADDRESS == 8'h41) & ~nRW & ~n1MHZE & cleanPGFC) ? 1'b0 : 1'b1;
	
	assign nFC40WR = ((bbc_ADDRESS == 8'h40) & nRW & ~n1MHZE & cleanPGFC) ? 1'b0 : 1'b1;
	assign nFC42WR = ((bbc_ADDRESS == 8'h42) & nRW & ~n1MHZE & cleanPGFC) ? 1'b0 : 1'b1;
	assign nFC43WR = ((bbc_ADDRESS == 8'h43) & nRW & ~n1MHZE & cleanPGFC) ? 1'b0 : 1'b1;
	assign nFC44WR = ((bbc_ADDRESS == 8'h44) & nRW & ~n1MHZE & cleanPGFC) ? 1'b0 : 1'b1;

endmodule
