kgl2001/BeebSCSIHostAdaptor/(notices)

Notices in the files:
SCSIAdaptorXC9572-64 - Rev 02/SCSIAdaptor_AMPPower.kicad_pcb:
© Ken Lowe
SCSIConnector - 50 pin/SCSIConnector.kicad_pcb:
© Ken Lowe - Feb 2020
